KylePark0/PIXIE/README.md

# PIXIE
Permanent repository of the PIXIE Open-Source Fluorometer Project

> [!IMPORTANT]
> **Terms of use:** All designs, documents, electronic files, source code, and any other original or derivative works made by or for the PIXIE Open-Source Fluorometer Project are made available under the Creative Commons Attribution 4.0 (CC-BY-4.0) International License. The deed for this license can be found at https://creativecommons.org/licenses/by/4.0/. Consult LICENSE.md or the previous link for the full legal text of the license.
>
> Links to Software, documents such as part drawings from external vendors, and other such articles are compiled for convenience only and no warranty is provided for them.
