KylePark0/PIXIE/Documentation/README.md

# Documentation
This path contains thePIXIE: Complete User Guide. 

This document is provided as a complete guide to the assembly and use of the PIXIE, detailed Calibration information, and a detailed set of notes to inform the reader of how design decisions were made and how the device could be modified to suit the desires of the user.
