KylePark0/PIXIE/Hardware/RetainingCap/README.md

## Retaining Cap
This path contains the drawing and CAD models of the default-configuration PIXIE's Retaining Cap, used to mate and seal the Custom Window to the device's O-ring flange. The cap is to be machined from 6061-T6 Aluminum and then Anodized with a clear (raw aluminum) or Black finish. To obtain the Retaining Cap, provide these files to a local or shipment-capable Machine shop.
