KylePark0/PIXIE/Hardware/CustomWindow/README.md

## Custom Window
This path contains drawings and sample CAD models of the default-configuration PIXIE's glass Custom Window. The PDF drawing of the Custom Window specifies the dimensions, tolerances, optical properties, and material of the Window as manufactured by Edmund Optics. Provide these details to an Optics Manufacturer or use Edmund Optics' online portal: 

https://www.edmundoptics.com/tools/borofloat/
