KylePark0/PIXIE/Hardware/README.md

# Hardware
This path contains files for manufacturing the custom mechanical components for the PIXIE. Specifically, it contains documents, drawings, and files for producing the default-configuration PIXIE's glass Custom Window, the custom Retaining Cap, and the 3D printed Optical Stack and Optical Cap parts.

This path also contains a subdirectory of Alternative Hardware files. Specifically, it contains files for a custom Locking Flange and Retaining Cap that can accept an off-the-shelf glass window.
