KylePark0/PIXIE/Hardware/AlternateHardware/PIXIE_RetainingCapAlternate.SLDPRT

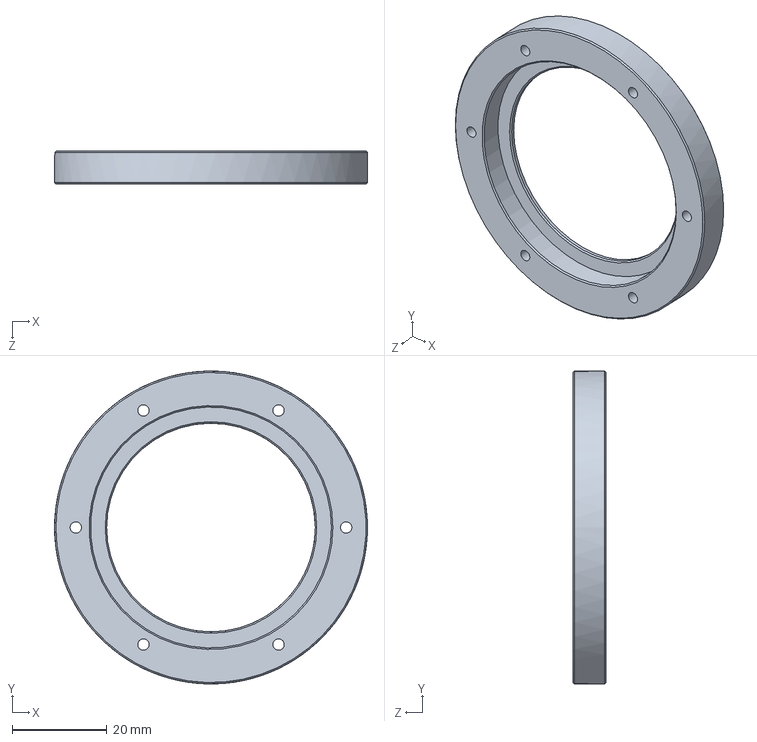
[picture p1: CAD file, 2024-04-20]
Hardware/AlternateHardware/PIXIE_RetainingCapAlternate.SLDPRT
66.0 x 66.0 x 7.00 mm
