KylePark0/PIXIE/Hardware/OpticalCap/PIXIE_OpticalCap.STEP

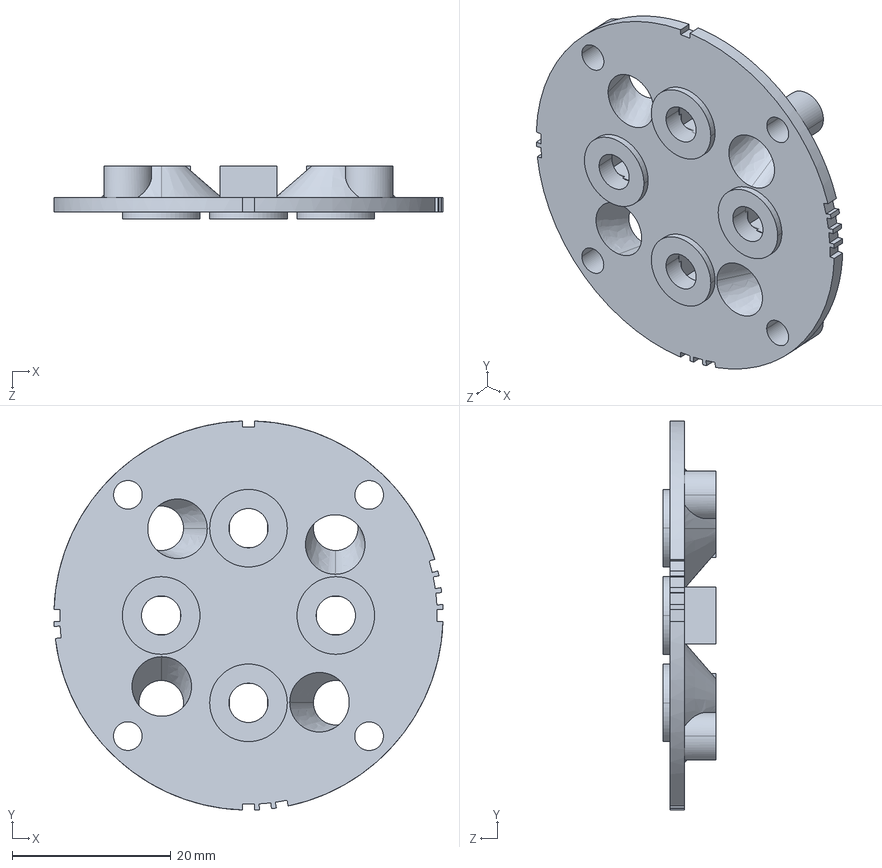
[picture p3: CAD file, 2024-04-15]
Hardware/OpticalCap/PIXIE_OpticalCap.STEP
49.0 x 49.0 x 6.65 mm
