KylePark0/PIXIE/Hardware/OpticalStack/PIXIE_OpticalStack.STEP

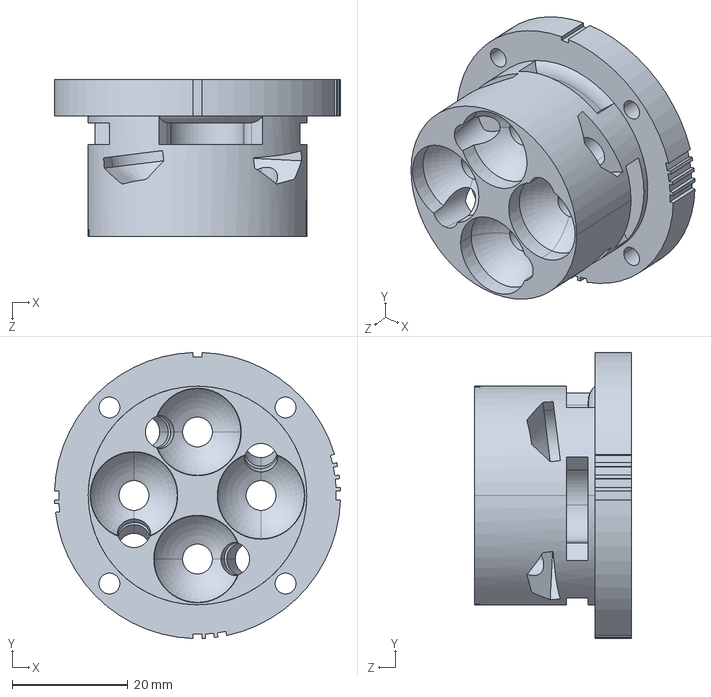
[picture p4: CAD file, 2024-04-15]
Hardware/OpticalStack/PIXIE_OpticalStack.STEP
49.5 x 49.5 x 27.2 mm
