KylePark0/PIXIE/Hardware/RetainingCap/PIXIE_RetainingCap.STEP

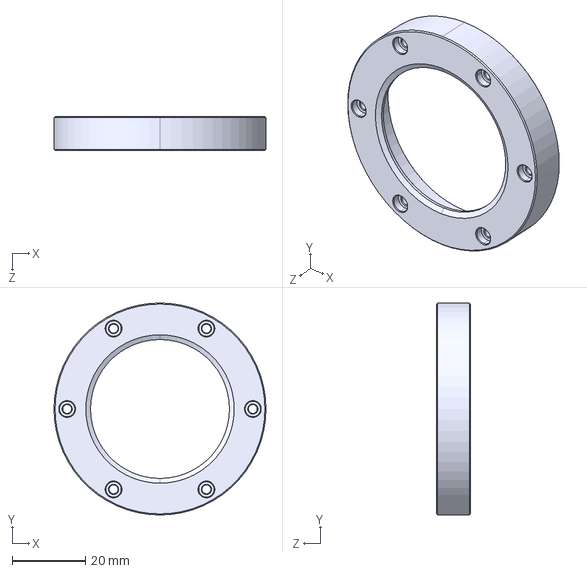
[picture p5: CAD file, 2024-04-14]
Hardware/RetainingCap/PIXIE_RetainingCap.STEP
58.0 x 58.0 x 9.25 mm
