KylePark0/PIXIE/Hardware/AlternateHardware/PIXIE_ORingFlangeAlternate.SLDPRT

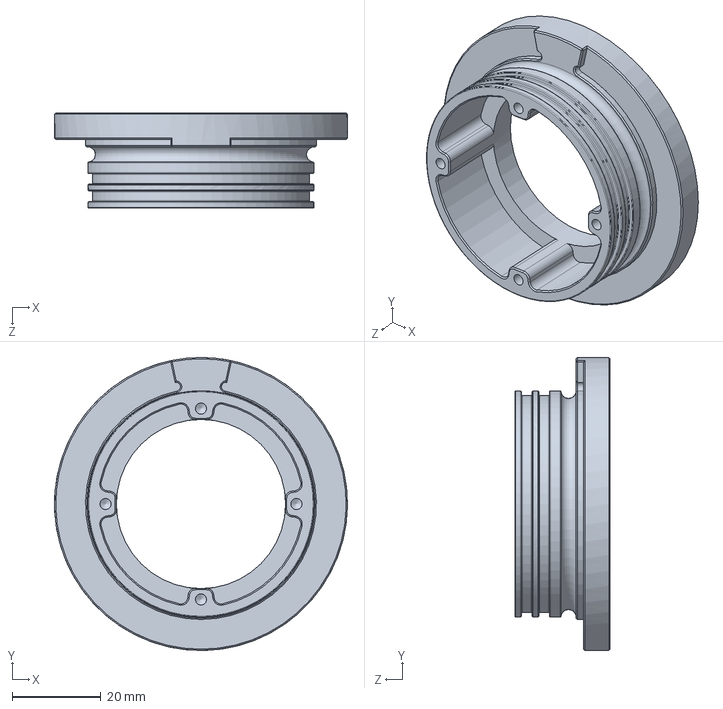
[picture p6: CAD file, 2024-04-20]
Hardware/AlternateHardware/PIXIE_ORingFlangeAlternate.SLDPRT
66.0 x 66.0 x 21.5 mm
