KylePark0/PIXIE/(list of files, cad)

Other CAD files:
Firmware/PIXIE_MSP430/Debug/src/wdt.obj
Firmware/PIXIE_MSP430/Debug/src/bak.obj
Firmware/PIXIE_MSP430/Debug/src/uart.obj
Firmware/PIXIE_MSP430/Debug/src/pixie.obj
Firmware/PIXIE_MSP430/Debug/src/dsp.obj
Firmware/PIXIE_MSP430/Debug/src/clk.obj
Firmware/PIXIE_MSP430/Debug/src/timer.obj
Firmware/PIXIE_MSP430/Debug/src/channels.obj
Firmware/PIXIE_MSP430/Debug/src/gpio.obj
Firmware/PIXIE_MSP430/Debug/src/cmd.obj
Firmware/PIXIE_MSP430/Debug/src/sineref.obj
Firmware/PIXIE_MSP430/Debug/src/opamp.obj
Firmware/PIXIE_MSP430/Debug/src/dma.obj
Firmware/PIXIE_MSP430/Debug/src/adc.obj
Firmware/PIXIE_MSP430/Debug/src/dac.obj
Firmware/PIXIE_MSP430/Debug/src/state.obj
Hardware/AlternateHardware/PIXIE_ORingFlangeAlternate.SLDDRW
Hardware/AlternateHardware/PIXIE_RetainingCapAlternate.SLDDRW
Hardware/CustomWindow/PIXIE_CustomWindow.SLDPRT
Hardware/OpticalCap/PIXIE_OpticalCap.SLDPRT
Hardware/OpticalCap/PIXIE_OpticalCap.STL
Hardware/OpticalStack/PIXIE_OpticalStack.SLDPRT
Hardware/OpticalStack/PIXIE_OpticalStack.STL
Hardware/RetainingCap/PIXIE_RetainingCap.SLDPRT
