KylePark0/PIXIE/Hardware/AlternateHardware/PIXIE_ORingFlangeAlternate.pdf

1

2

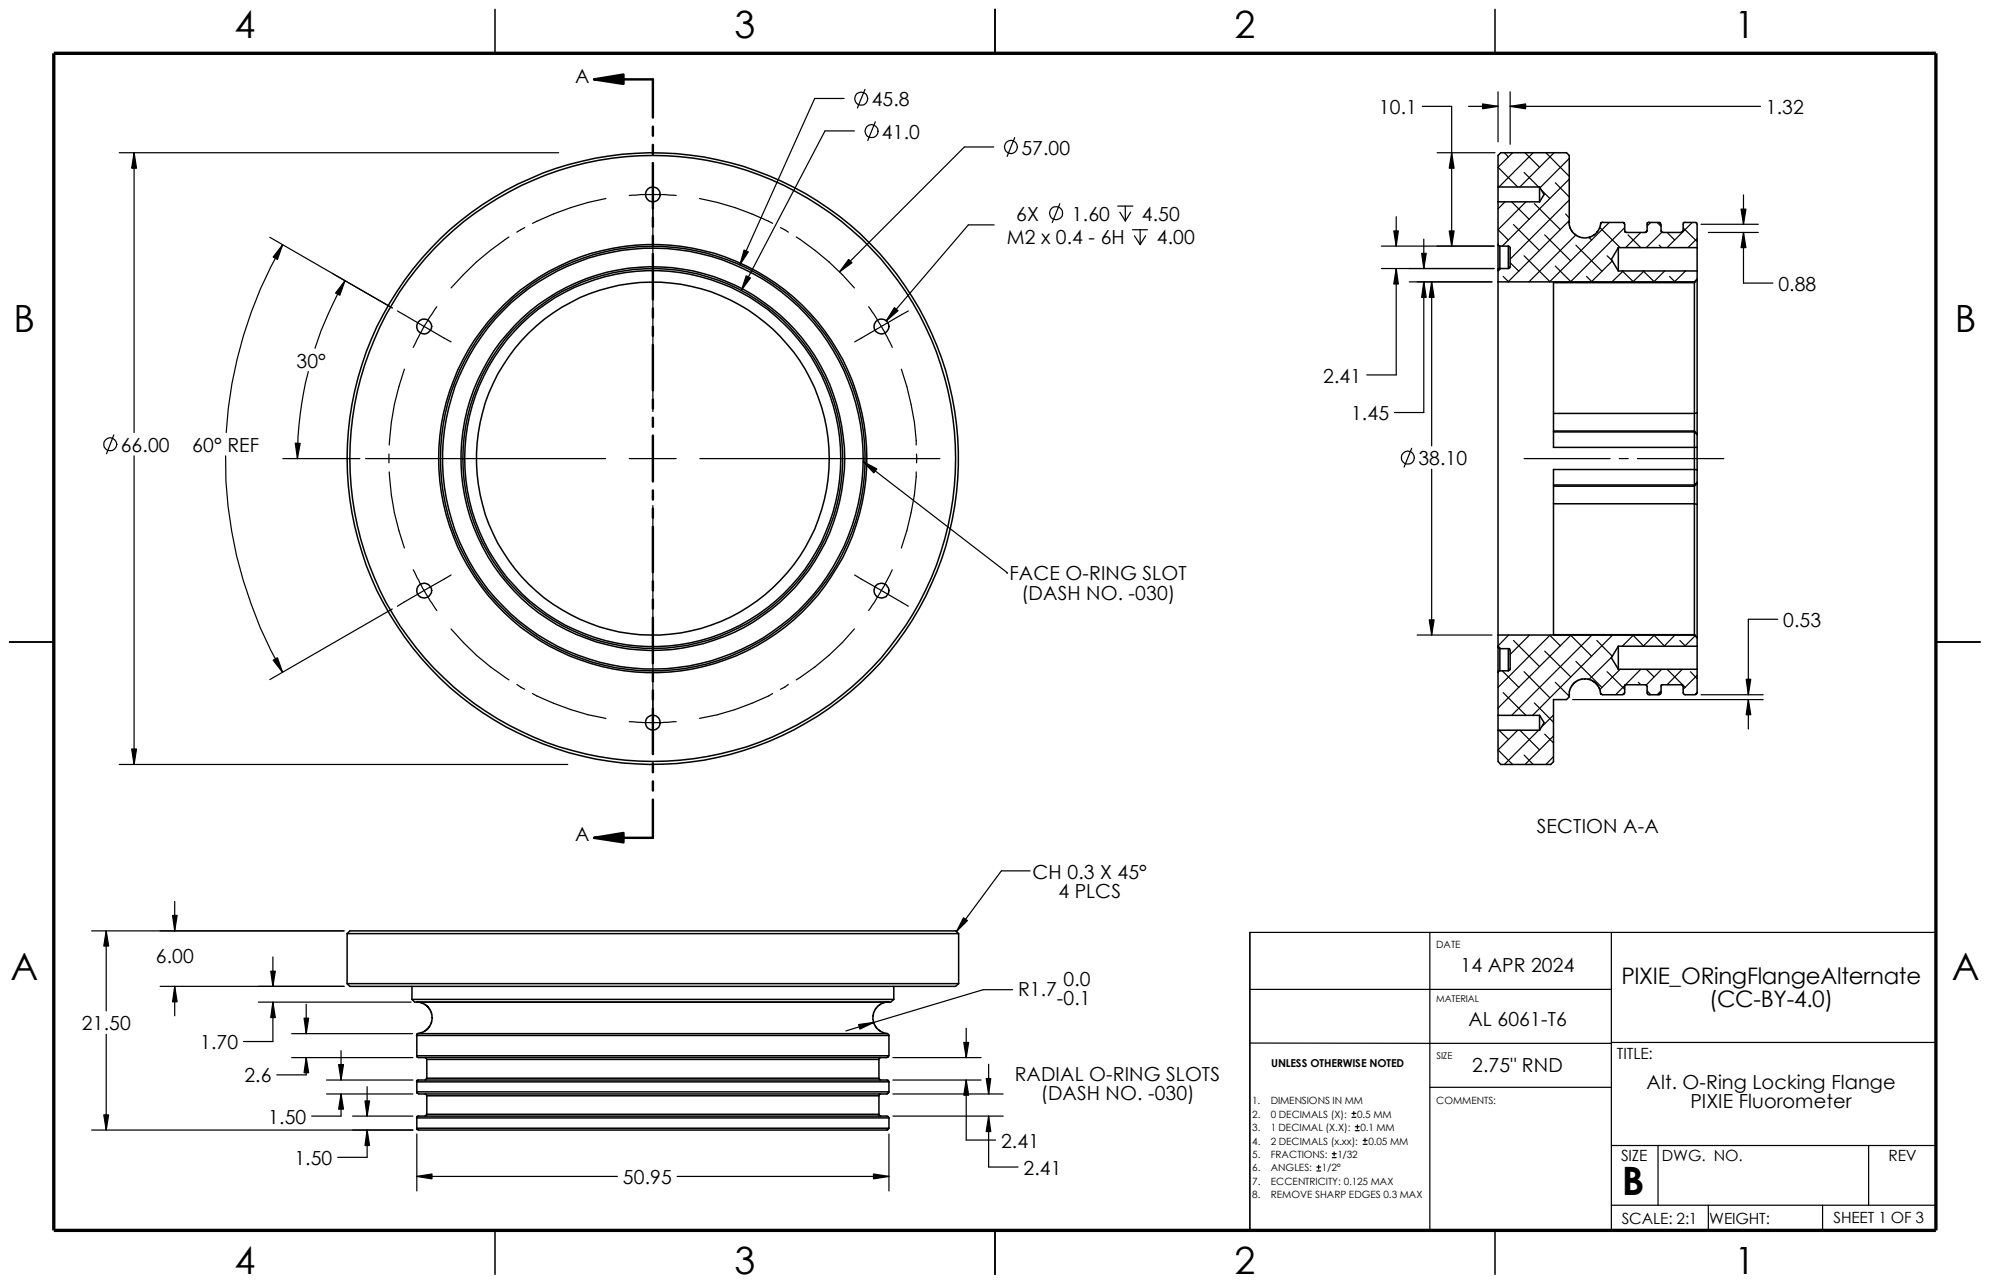
[picture p7: page 1]
COMMENTS:; CH 0.3 X 45° 4 PLCS; SECTION A-A; 66.00 60° REF

FACE O-RING SLOT
(DASH NO. -030)

DATE 14 APR 2024 | PIXIE_ORingFlangeAlternate (CC-BY-4.0)

MATERIAL AL 6061-T6

UNLESS OTHERWISE NOTED DIMENSIONS IN MM1. 0 DECIMALS (X): 0.5 MM2. 1 DECIMAL (X.X): 0.1 MM3. 2 DECIMALS (x.xx): 0.05 MM4. FRACTIONS: 1/325. ANGLES: 1/2°6. ECCENTRICITY: 0.125 MAX7. 8. REMOVE SHARP EDGES 0.3 MAX | SIZE 2.75" RND | TITLE: Alt. O-Ring Locking Flange PIXIE Fluorometer

RADIAL O-RING SLOTS

SIZE B | DWG. NO. | REV

SCALE: 2:1 | WEIGHT: | SHEET 1 OF 3

1

2

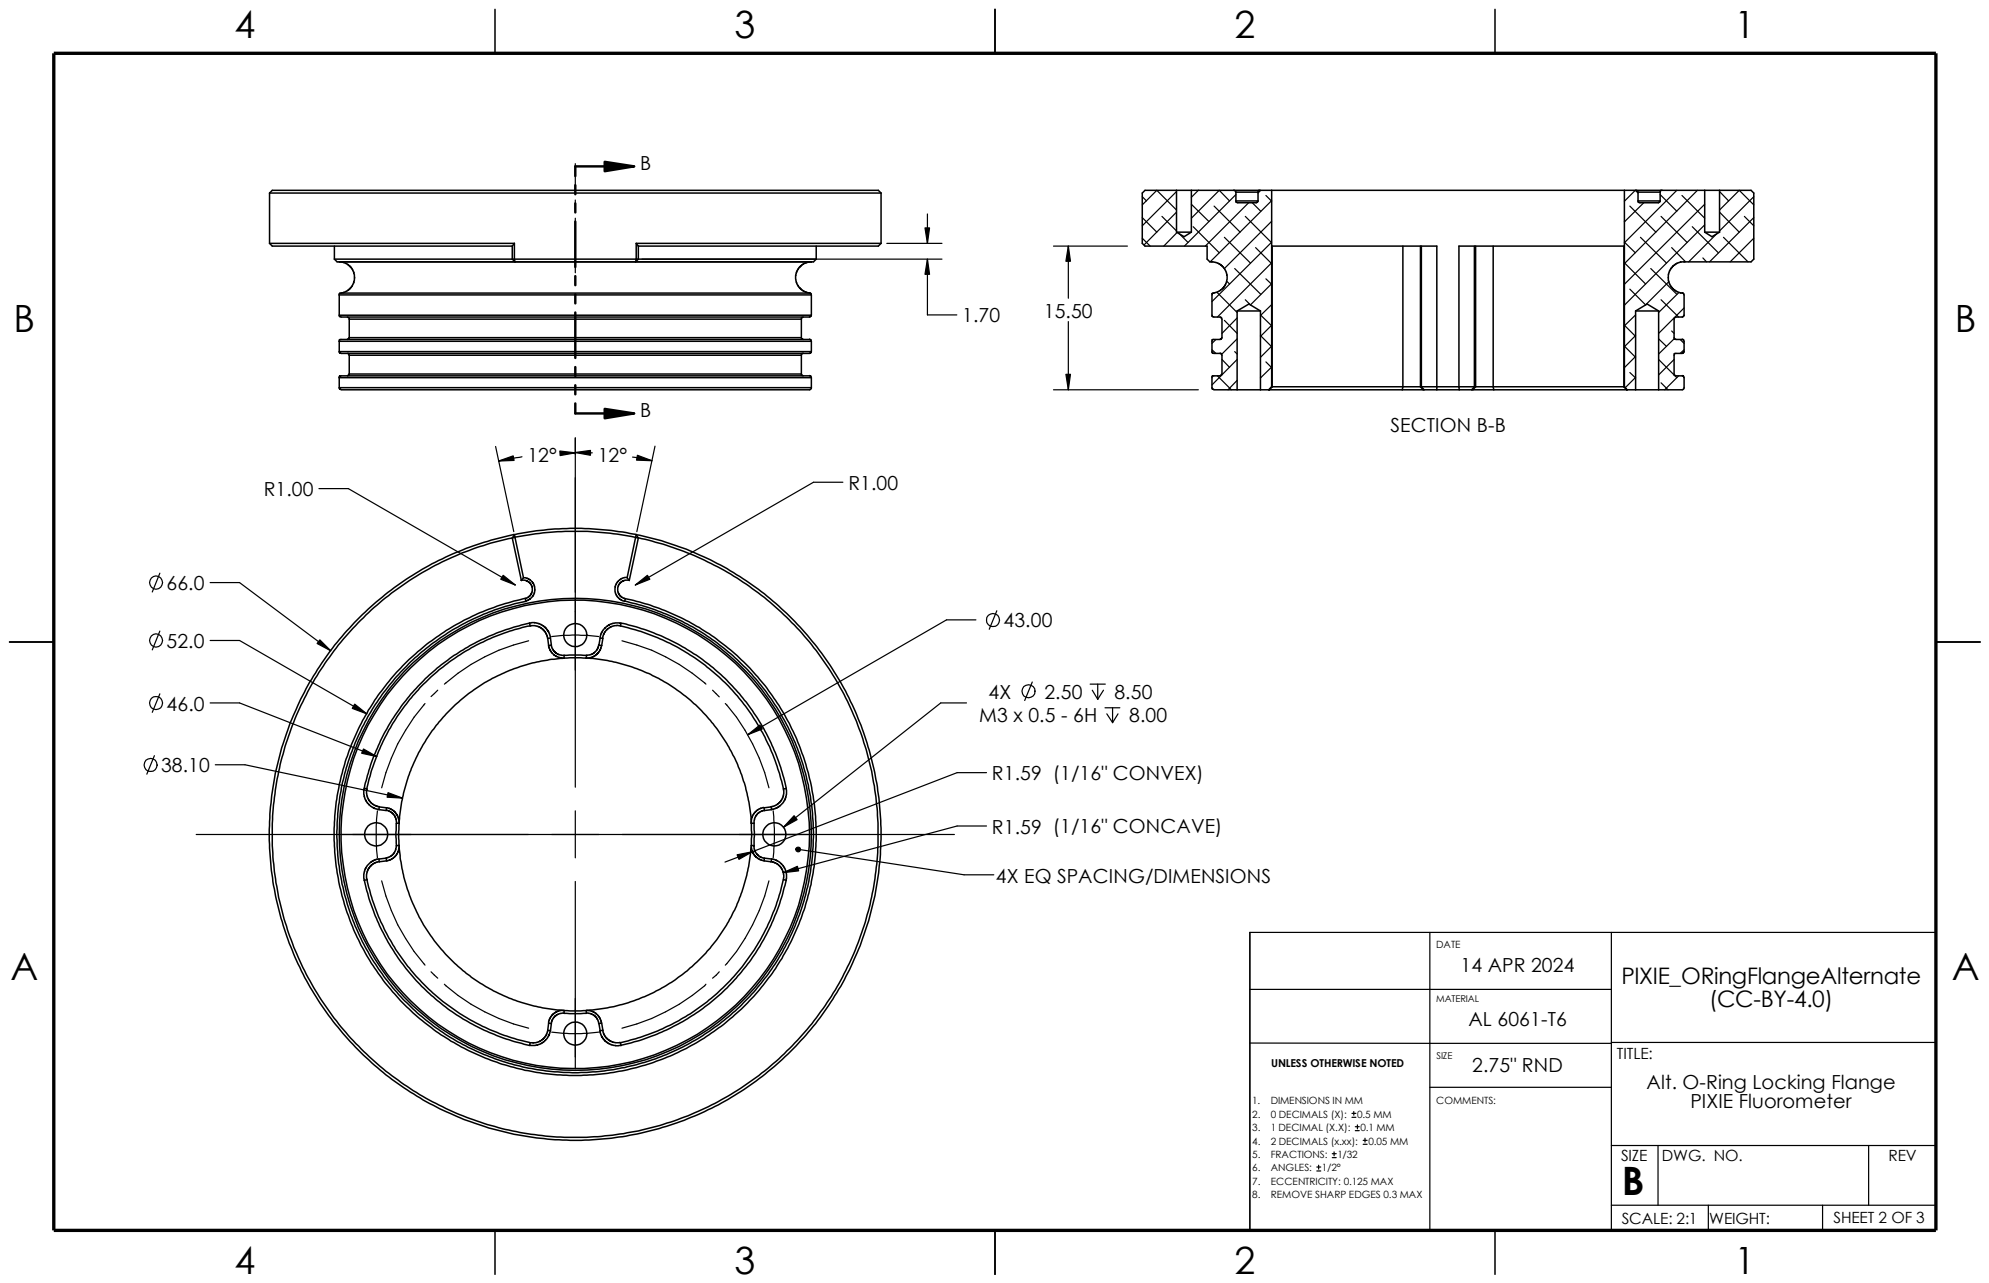
[picture p8: page 2]
COMMENTS:; (1/16" CONVEX); (1/16" CONCAVE); SECTION B-B

4X EQ SPACING/DIMENSIONS

DATE | PIXIE_ORingFlangeAlternate ¹⁴ APR 2024 (CC-BY-4.0)

MATERIAL AL 6061-T6

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

SIZE B | DWG. NO. | REV

SCALE: 2:1 | WEIGHT: | SHEET 2 OF 3

4

3

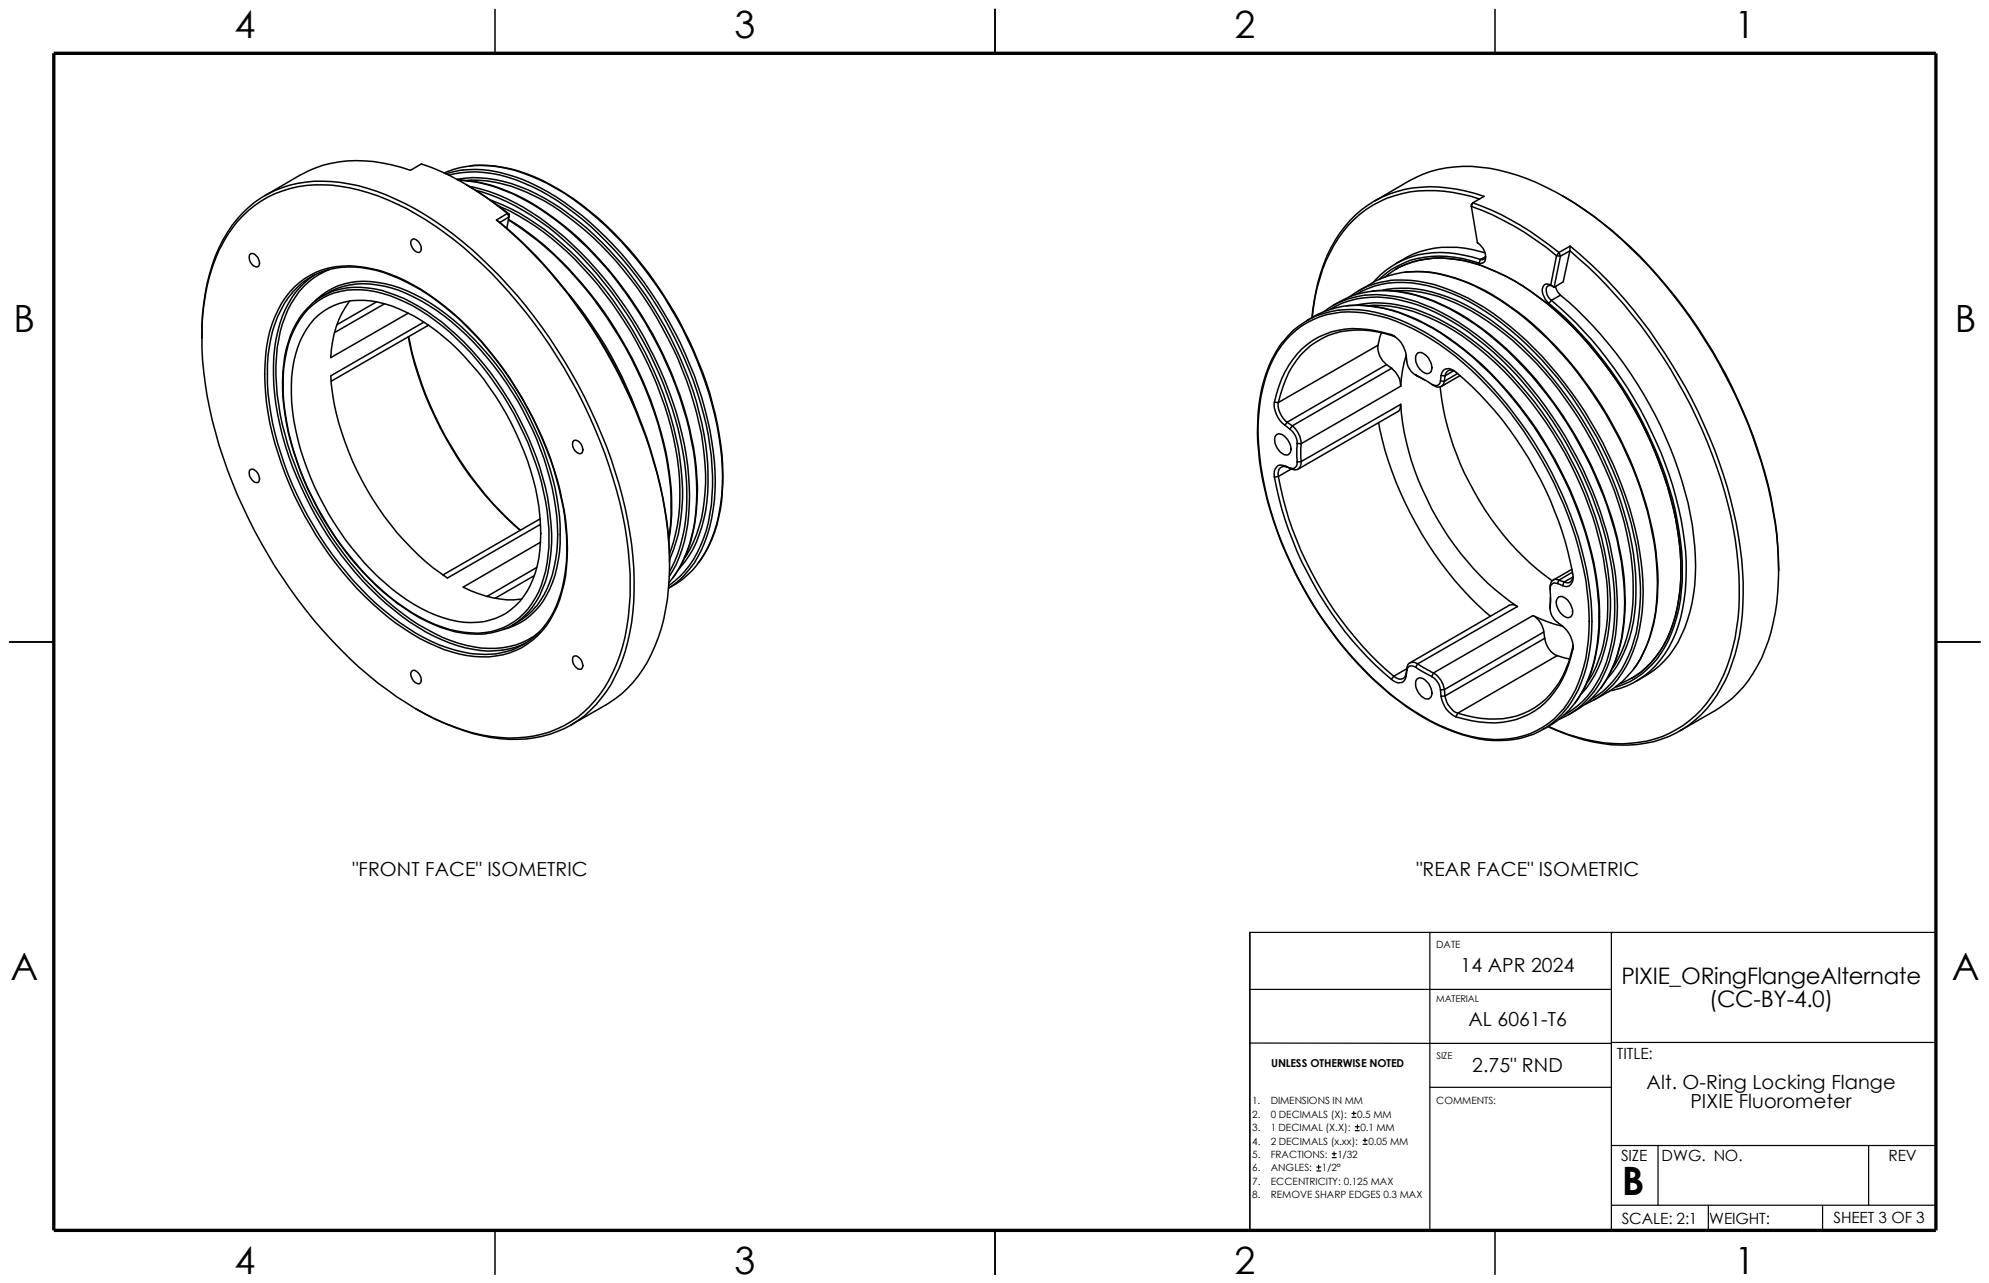
[picture p9: page 3]
COMMENTS:; "FRONT FACE" ISOMETRIC; "REAR FACE" ISOMETRIC

DATE 14 APR 2024 | PIXIE_ORingFlangeAlternate (CC-BY-4.0)

MATERIAL AL 6061-T6

UNLESS OTHERWISE NOTED DIMENSIONS IN MM1. 0 DECIMALS (X): 0.5 MM2. 1 DECIMAL (X.X): 0.1 MM3. 2 DECIMALS (x.xx): 0.05 MM4. FRACTIONS: 1/325. ANGLES: 1/2°6. ECCENTRICITY: 0.125 MAX7. REMOVE SHARP EDGES 0.3 MAX8. | 2.75" RND SIZE | TITLE: Alt. O-Ring Locking Flange PIXIE Fluorometer

SIZE B | DWG. NO. | REV

SCALE: 2:1 | WEIGHT: | SHEET 3 OF 3
