KylePark0/PIXIE/Hardware/AlternateHardware/PIXIE_RetainingCapAlternate.pdf

30°

# 60° REF

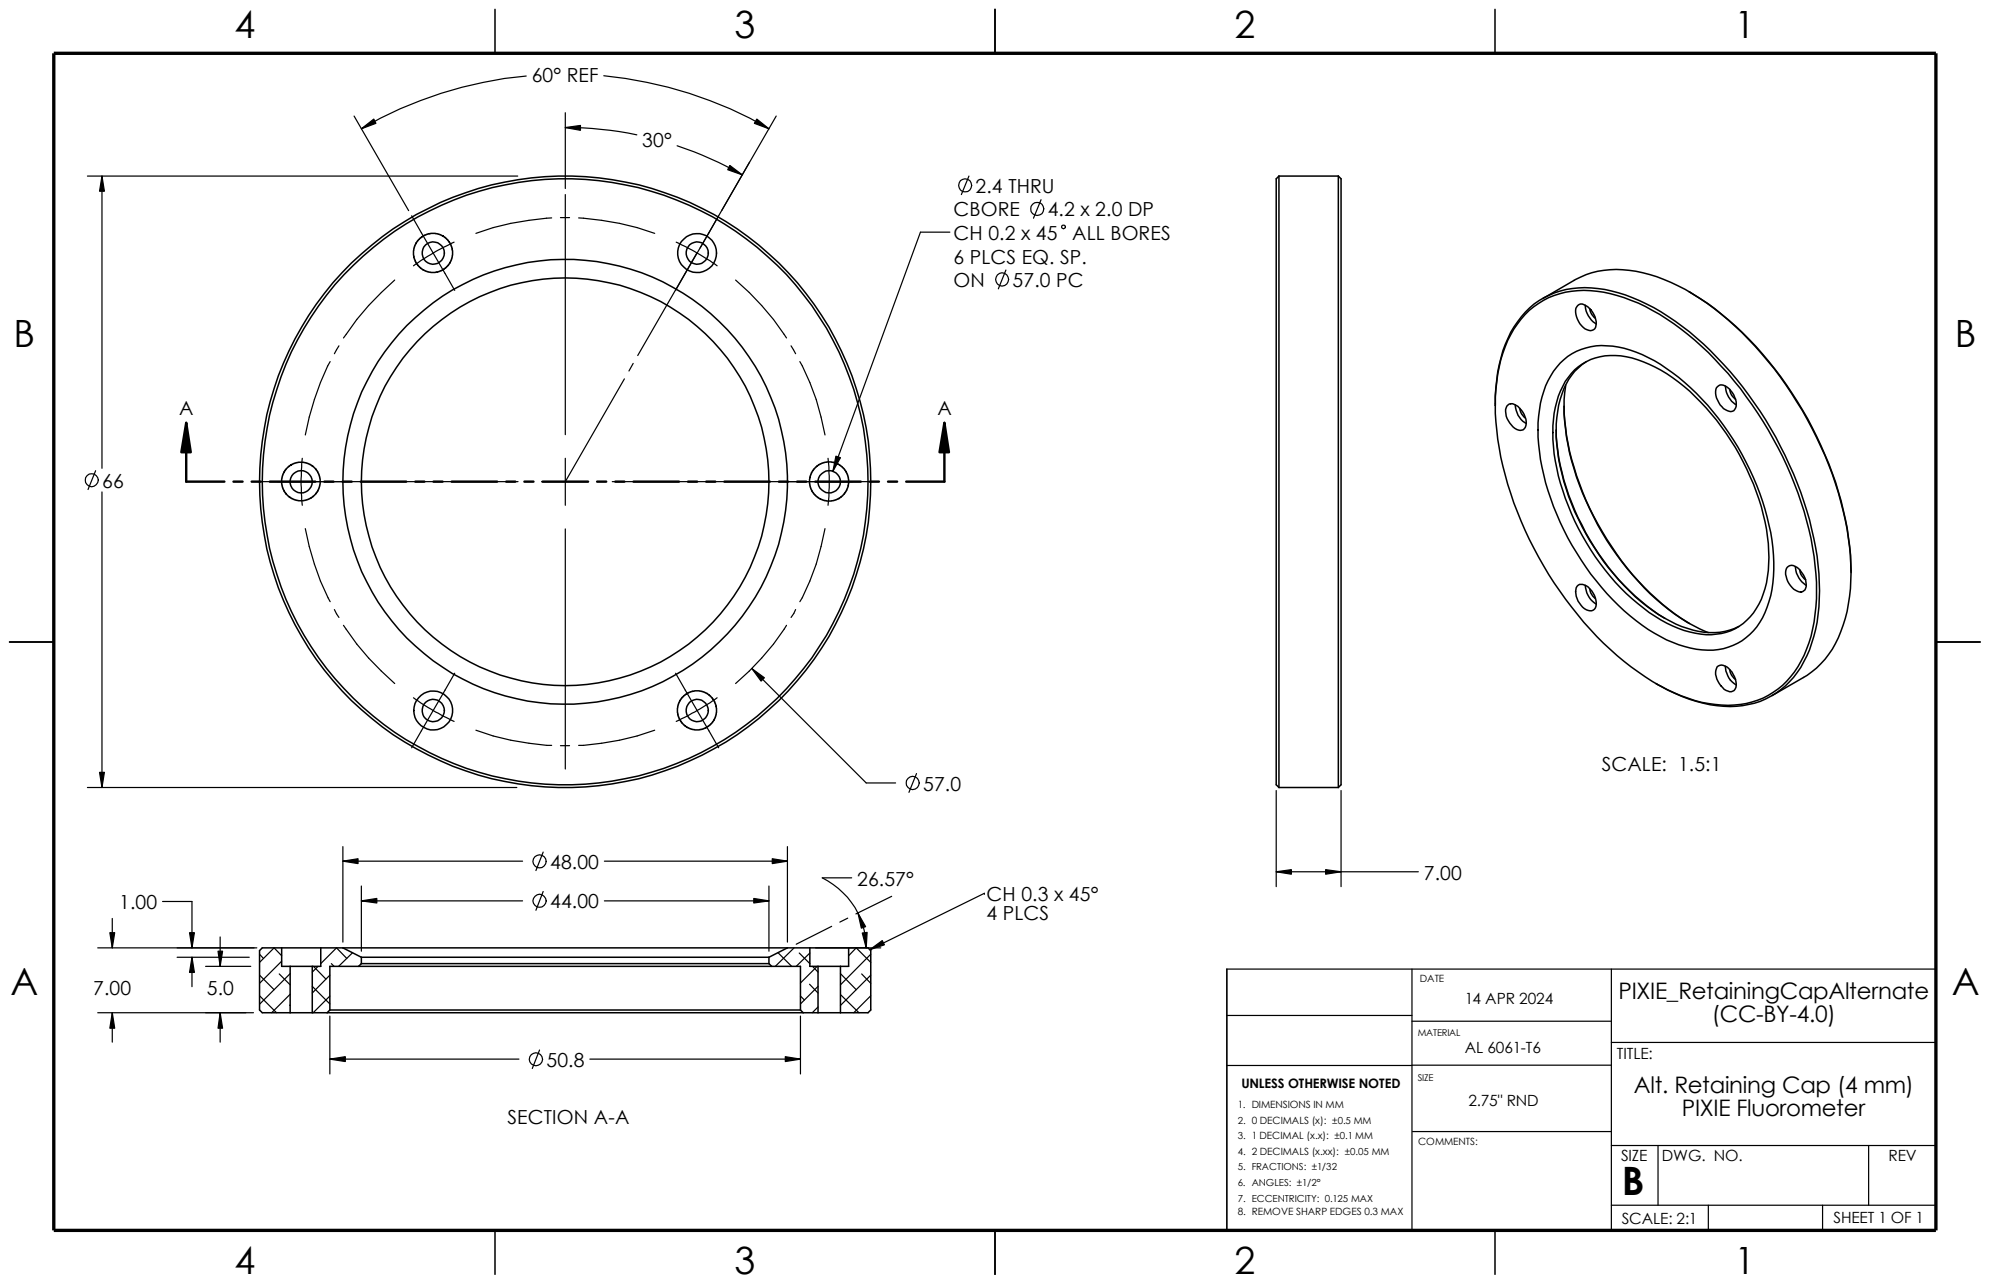
[picture p10: page 1]
CBORE; SCALE: 1.5:1; SECTION A-A; CH 0.3 x 45° 4 PLCS; 14 APR 2024; PIXIE_RetainingCapAlternate; DATE; PIXIE Fluorometer; TITLE:; COMMENTS:; MATERIAL; 0 DECIMALS (x): ±0.5 MM2.; 1 DECIMAL (x.x): ±0.1 MM3.; 2 DECIMALS (x.xx): ±0.05 MM4.; FRACTIONS: ±1/325.; ANGLES: ±1/2°6.; ECCENTRICITY: 0.125 MAX7. REMOVE SHARP EDGES 0.3 MAX8.; SIZE

2.4 THRU
CH 0.2 x 45 ALL BORES
6 PLCS EQ. SP.

Alt. Retaining Cap (4 mm) 2.75" RND UNLESS OTHERWISE NOTED DIMENSIONS IN MM1.

SIZE B | DWG. NO. | REV

SCALE: 2:1 | | SHEET 1 OF 1
