KylePark0/PIXIE/Hardware/RetainingCap/PIXIE_RetainingCap.pdf

30°

6.5 7.5- | 38 | -- | ------ | RECORD OF DRAWING CHANGES REV | DCR | DESCRIPTION | SHT | DATE | CHKD 0 | FIRST ISSUE | 14 APR 2024 NOTES: 1. BREAK ALL SHARP EDGES.

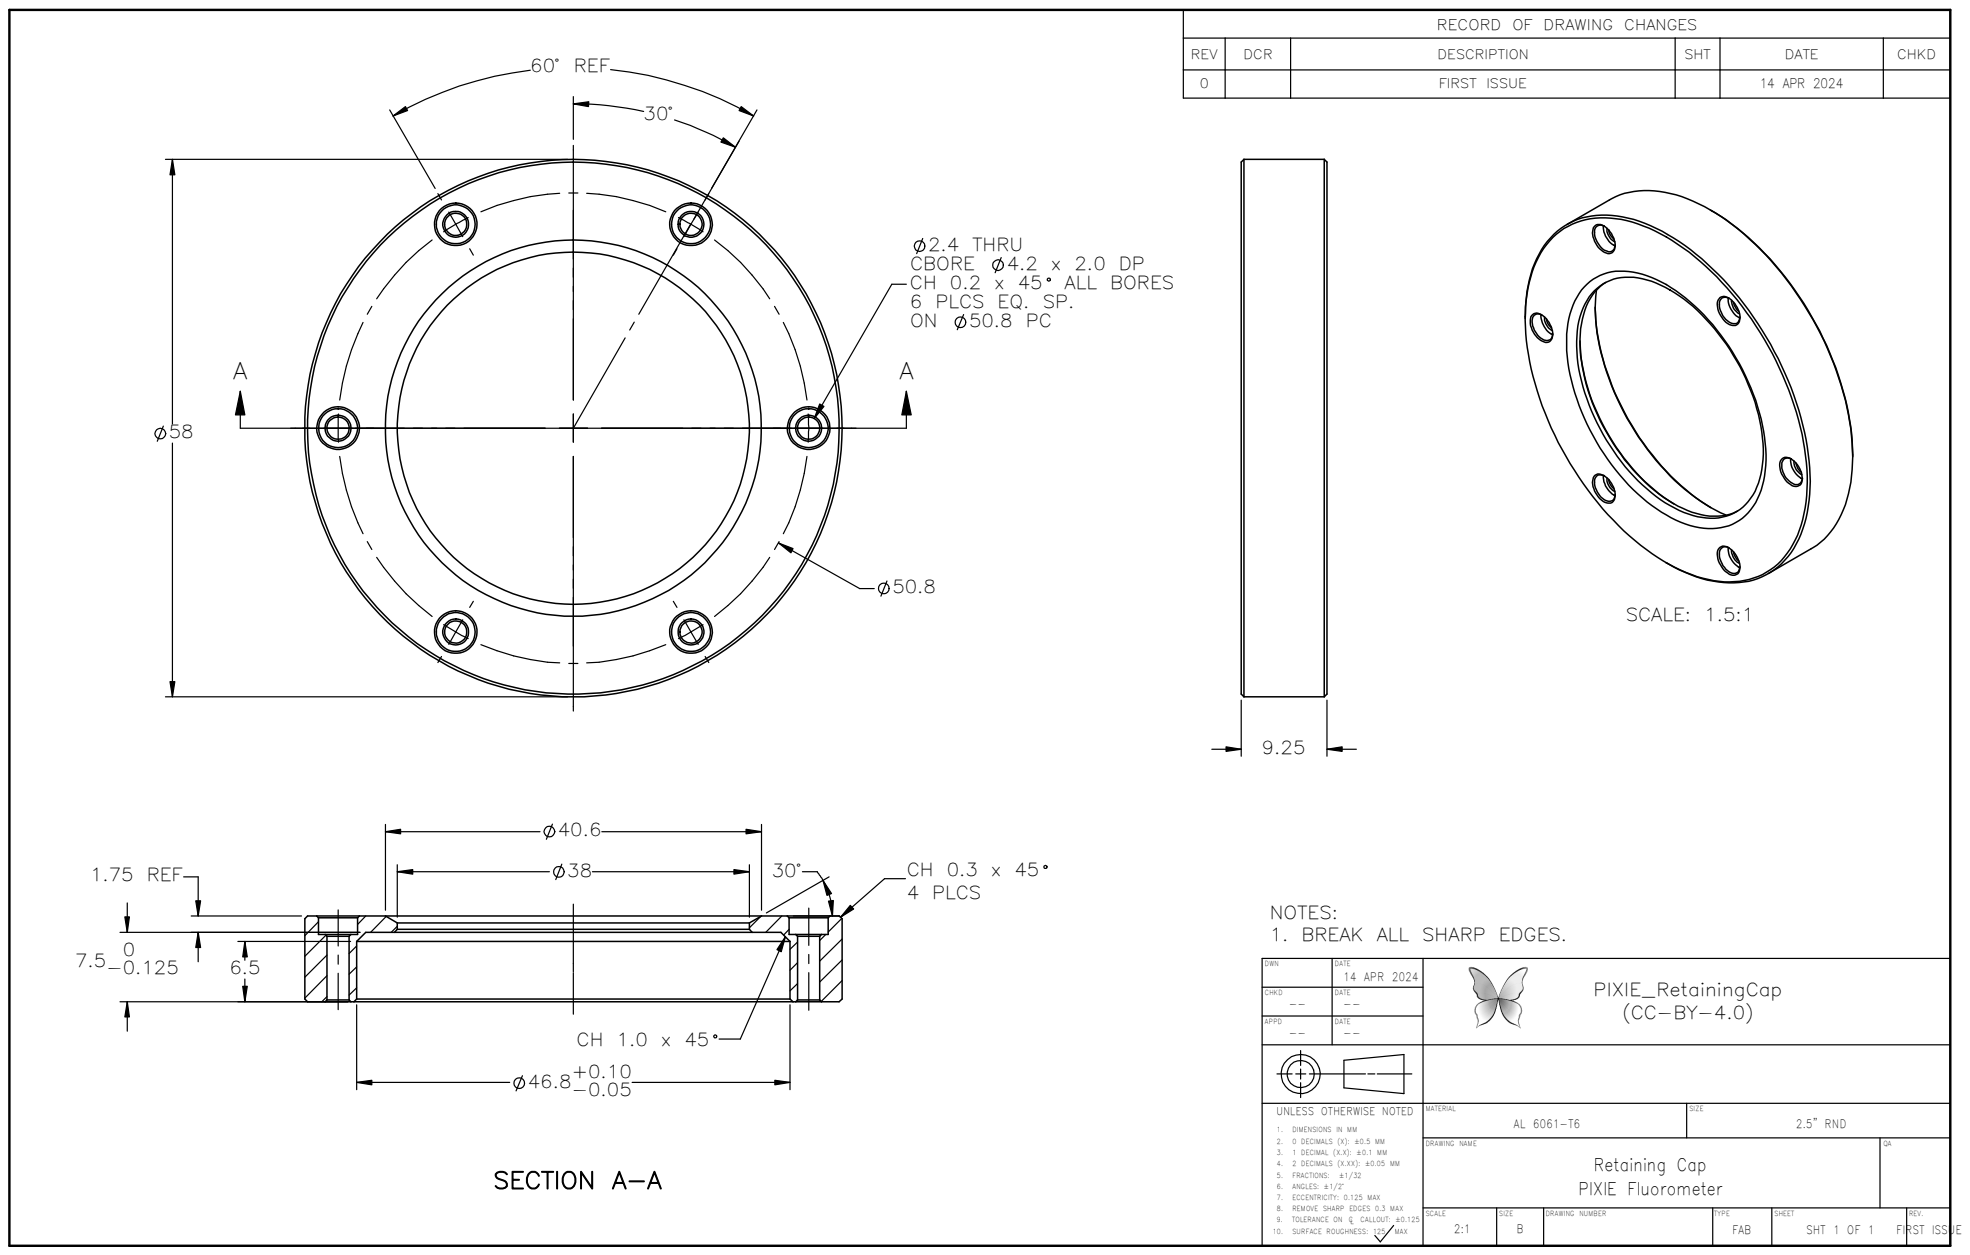
[picture p11: page 1]
SECTION A-A; 4 PLCS; - 1.75 REF; CBORE; 60° REF; SCALE: 1.5:1

2.4 THRU
CH 0.2 x 45 ALL BORES
6 PLCS EQ. SP.

DWN | DATE 14 APR 2024 | PIXIE_RetainingCap (CC-BY-4.0)

CHKD | DATE

APPD | DATE

UNLESS OTHERWISE NOTED 1. DIMENSIONS IN MM 2. 0 DECIMALS (X): ±0.5 MM 3. 1 DECIMAL (X.X): ±0.1 MM 4. 2 DECIMALS (X.XX): ±0.05 MM 5. FRACTIONS: ±1/32 6. ANGLES: ±1/2° 7. ECCENTRICITY: 0.125 MAX 8. REMOVE SHARP EDGES 0.3 MAX 9. TOLERANCE ON CL CALLOUT: ±0.125 10. SURFACE ROUGHNESS: 125 MAX | AL 6061-T6 | SIZEMATERIAL 2.5" RND

DRAWING NAME Retaining Cap PIXIE Fluorometer | QA

B2:1 | DRAWING NUMBERSCALE | TYPESIZE | SHEET SHT 1 OF 1 FIRST ISSUEFAB | REV.
