KylePark0/PIXIE/Electrical/PIXIE_PCB_Schematic.pdf

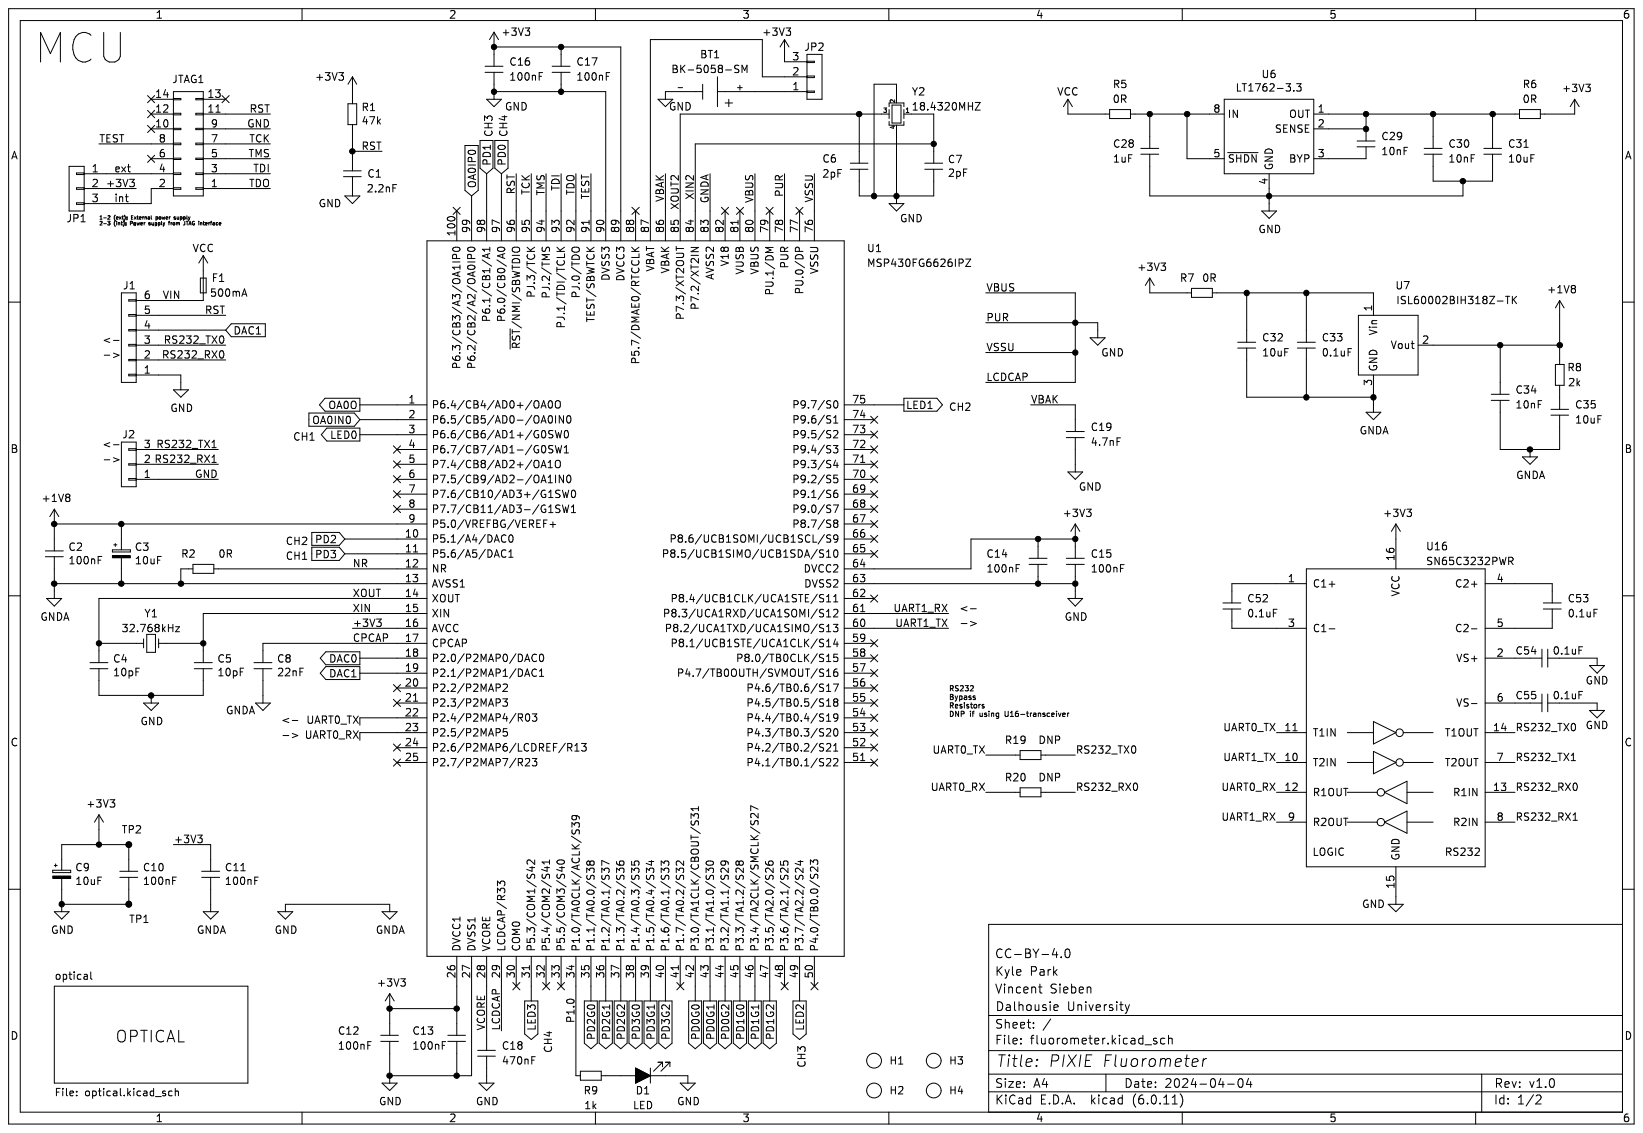
[picture p13: page 1]

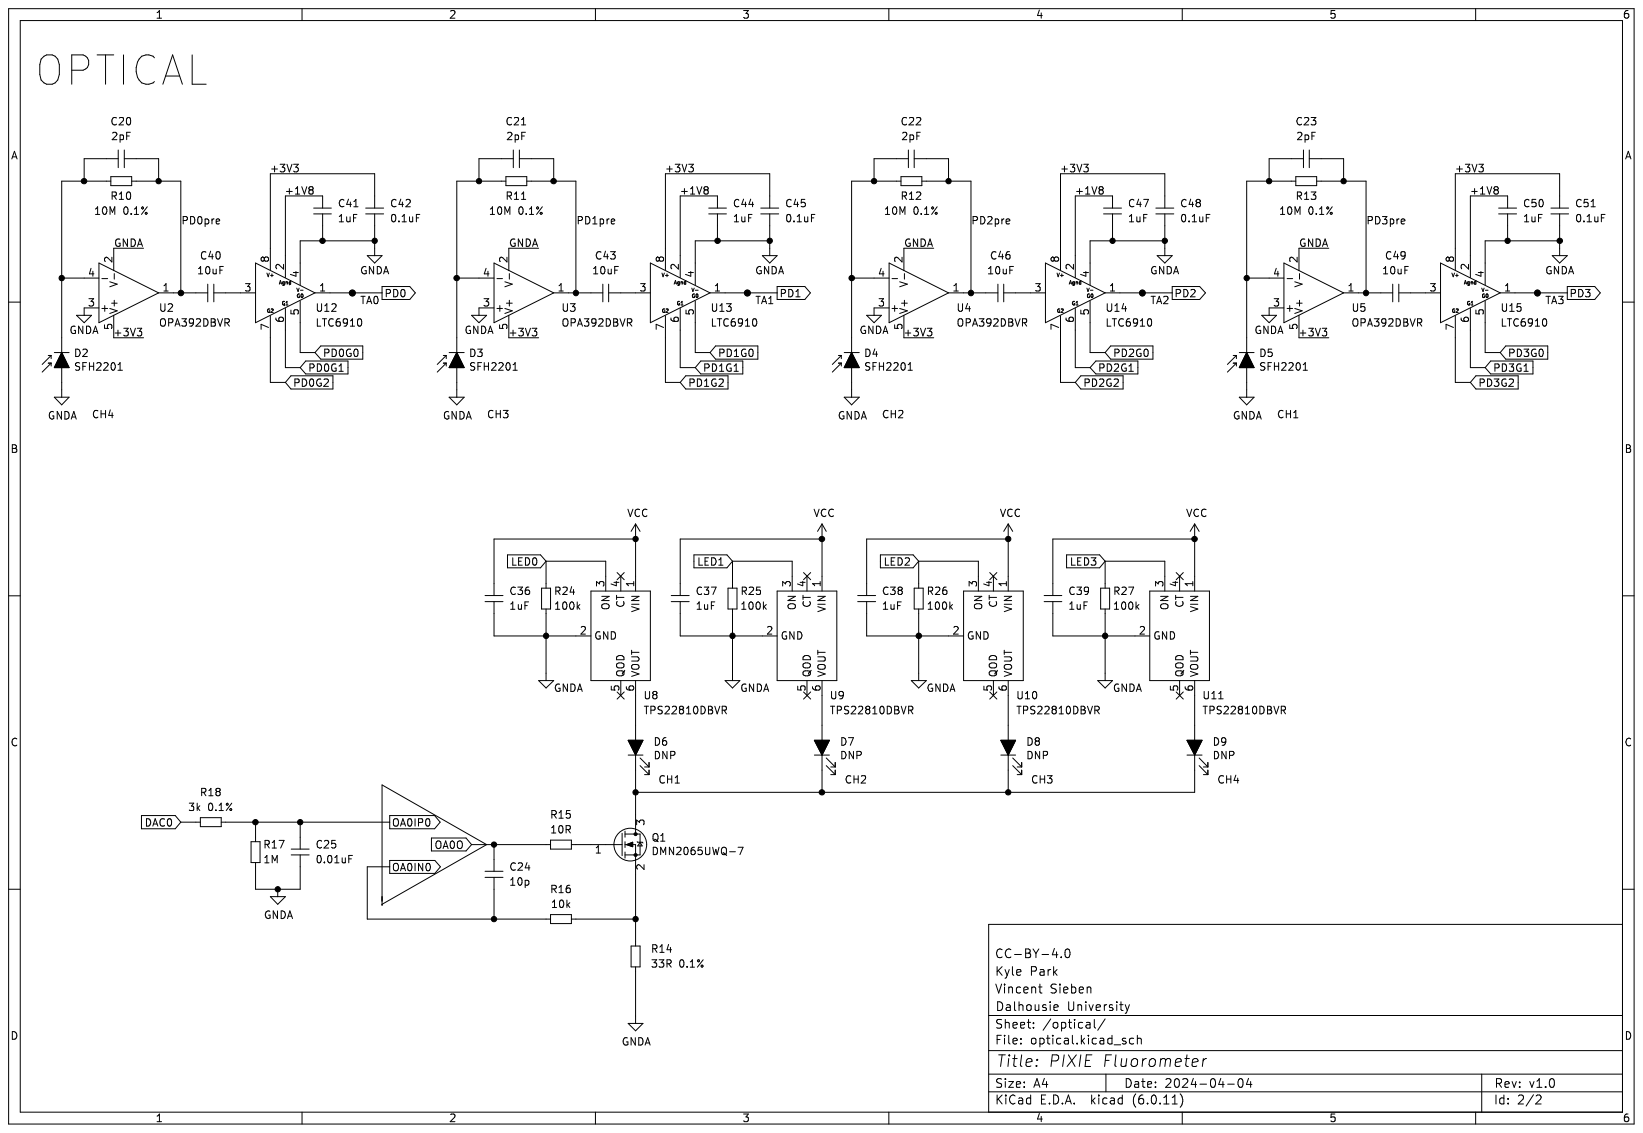
[picture p14: page 2]
