KylePark0/PIXIE/Firmware/PIXIE_MSP430/scratch.h

/*
 * scratch.h
 *
 *  Created on: Aug 23, 2024
 *      Author: kyle_
 */

#ifndef SCRATCH_H_
#define SCRATCH_H_


// This file distinguishes this CCS project as the current primary project of PIXIE.


#endif /* SCRATCH_H_ */
